mmaakkyyii/makyi_mouse_v2/README.md

# マッキーマウスv2
これはマッキーマウスの基板用リポジトリです  
ソフトは[こちら](https://github.com/mmaakkyyii/makyi_mouse_FW)

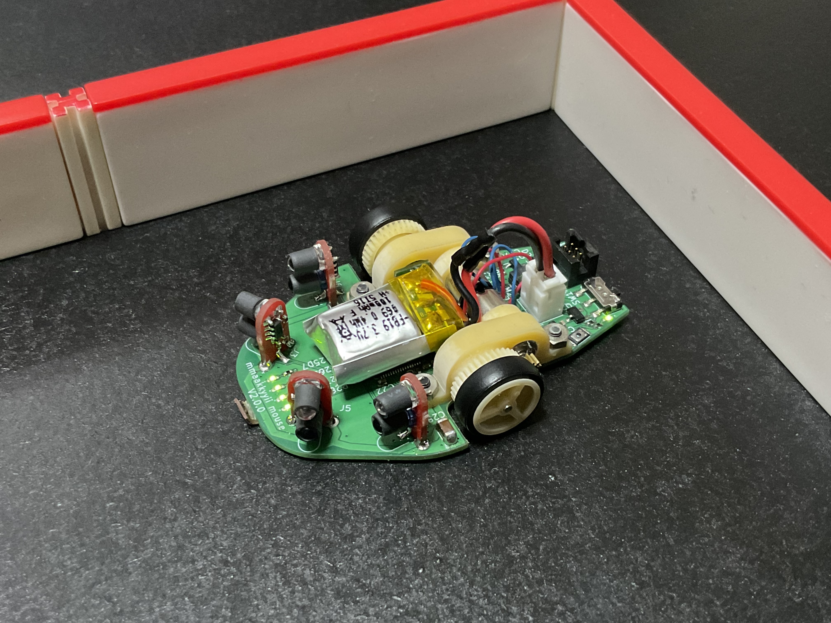
[picture p1: doc/mmaakkyyii_mouse_v2_0_1.jpg]
