mmaakkyyii/makyi_mouse_v2/doc/mmaakkyyii_mouse_v2_0_0.jpg

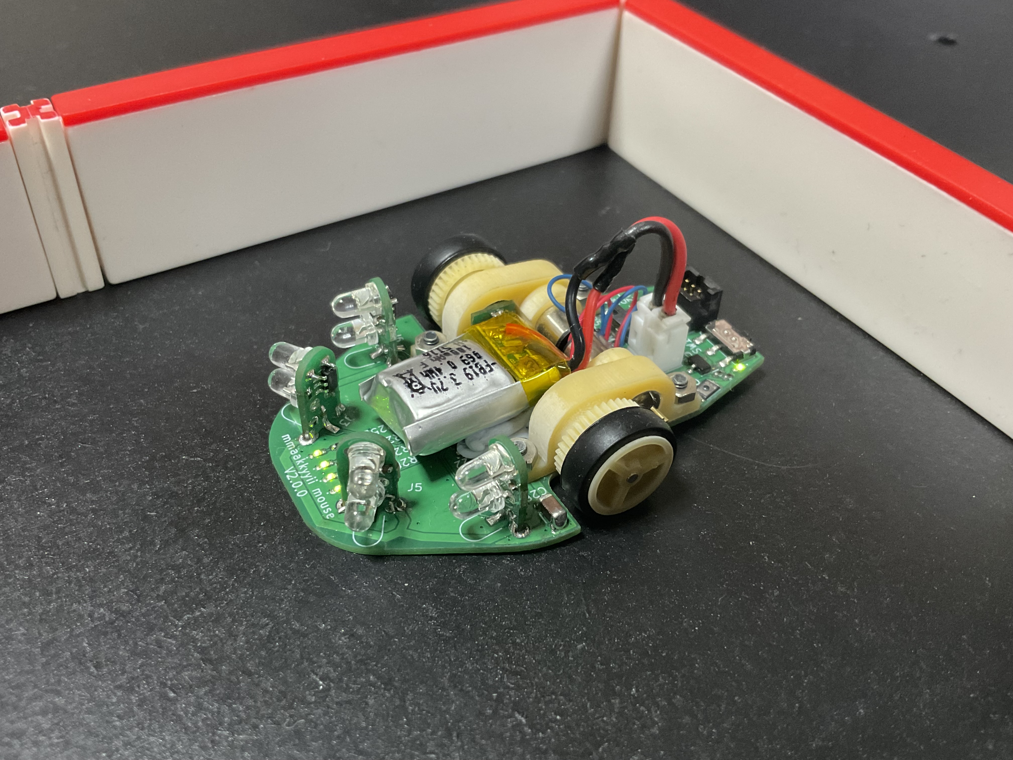
doc/mmaakkyyii_mouse_v2_0_0.jpg
