mmaakkyyii/makyi_mouse_v2/wall_sensor.step

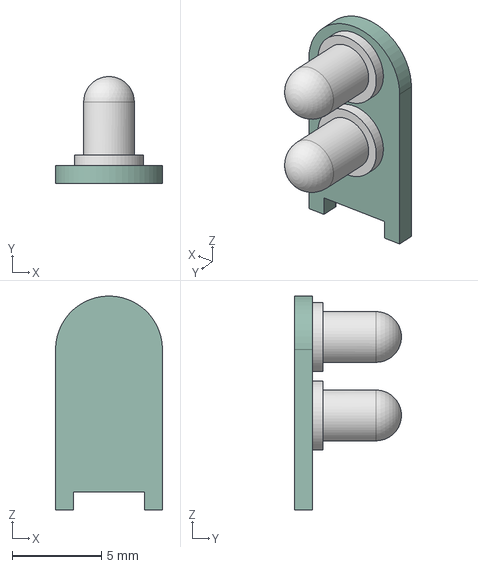
[picture p3: CAD file, 2024-06-23]
wall_sensor.step
6.00 x 6.00 x 12.0 mm
