mmaakkyyii/makyi_mouse_v2/mount_model_R.step

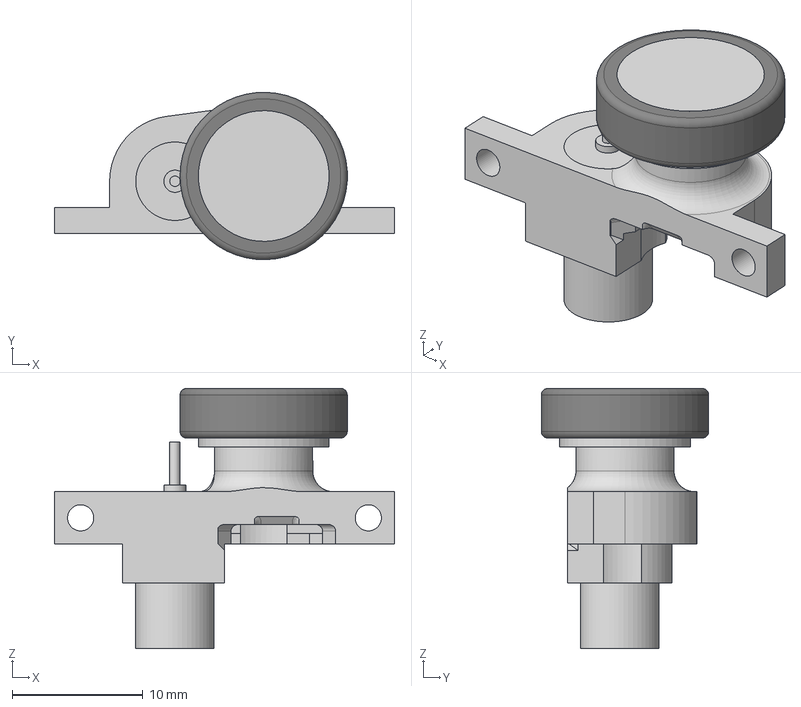
[picture p4: CAD file, 2024-06-23]
mount_model_R.step
26.0 x 12.8 x 19.9 mm
mount
NFP-D0612
tiya
