mmaakkyyii/makyi_mouse_v2/DRV8836.stp

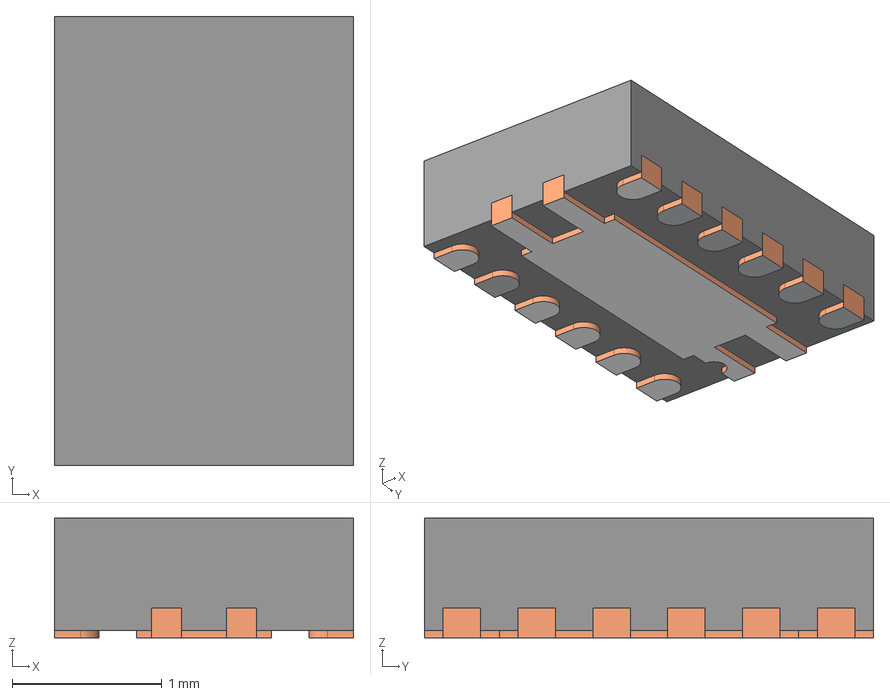
[picture p5: CAD file, 2024-06-23]
DRV8836.stp
2.00 x 3.00 x 0.8 mm
BODY-SON
FRAME-DSS0012A
PIN1-ID
