mmaakkyyii/makyi_mouse_v2/20021221-00006XXLFc.stp

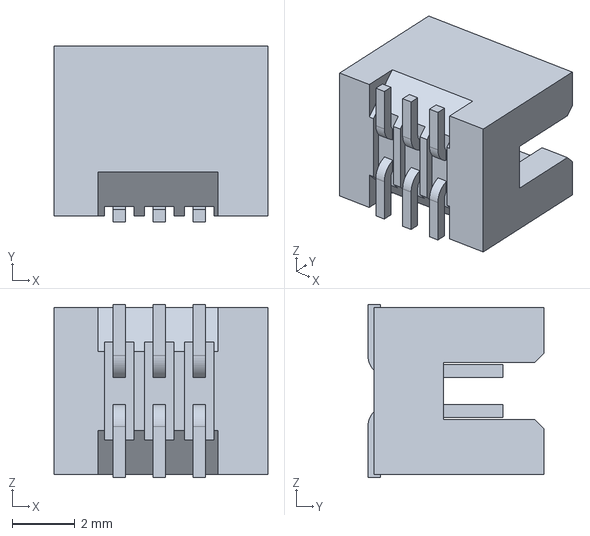
[picture p6: CAD file, 2024-06-23]
20021221-00006XXLFc.stp
6.80 x 5.60 x 5.50 mm
