mmaakkyyii/makyi_mouse_v2/(list of files, cad)

Other CAD files:
mount_model_L.step
