mmaakkyyii/makyi_mouse_v2/makyi_mouse.kicad_pcb

## KiCad design makyi_mouse.kicad_pcb (2024-06-29)

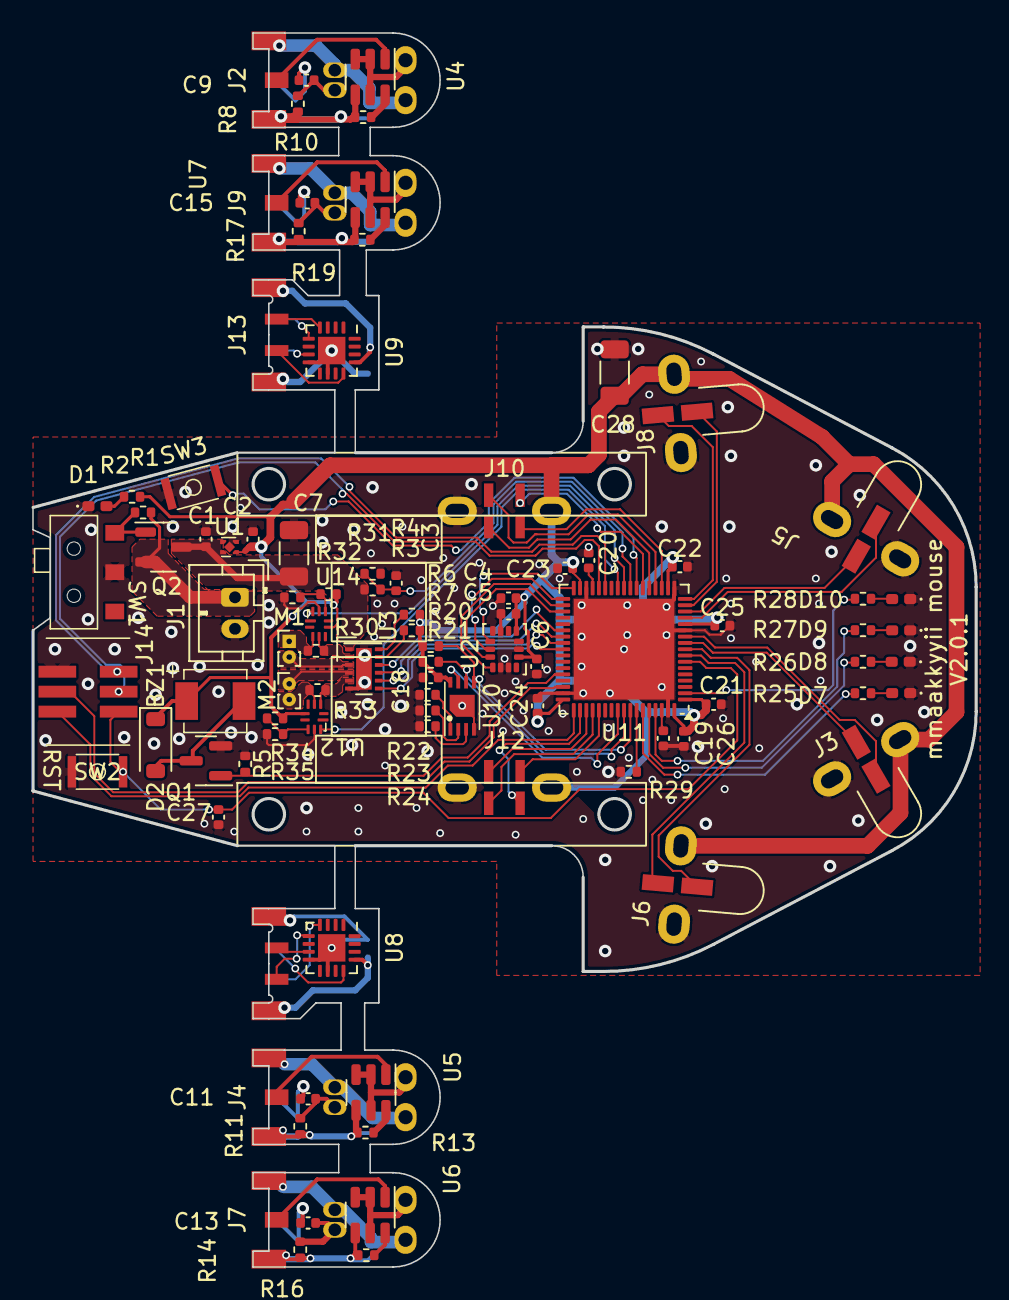
[picture p7: board makyi_mouse.kicad_pcb from above]

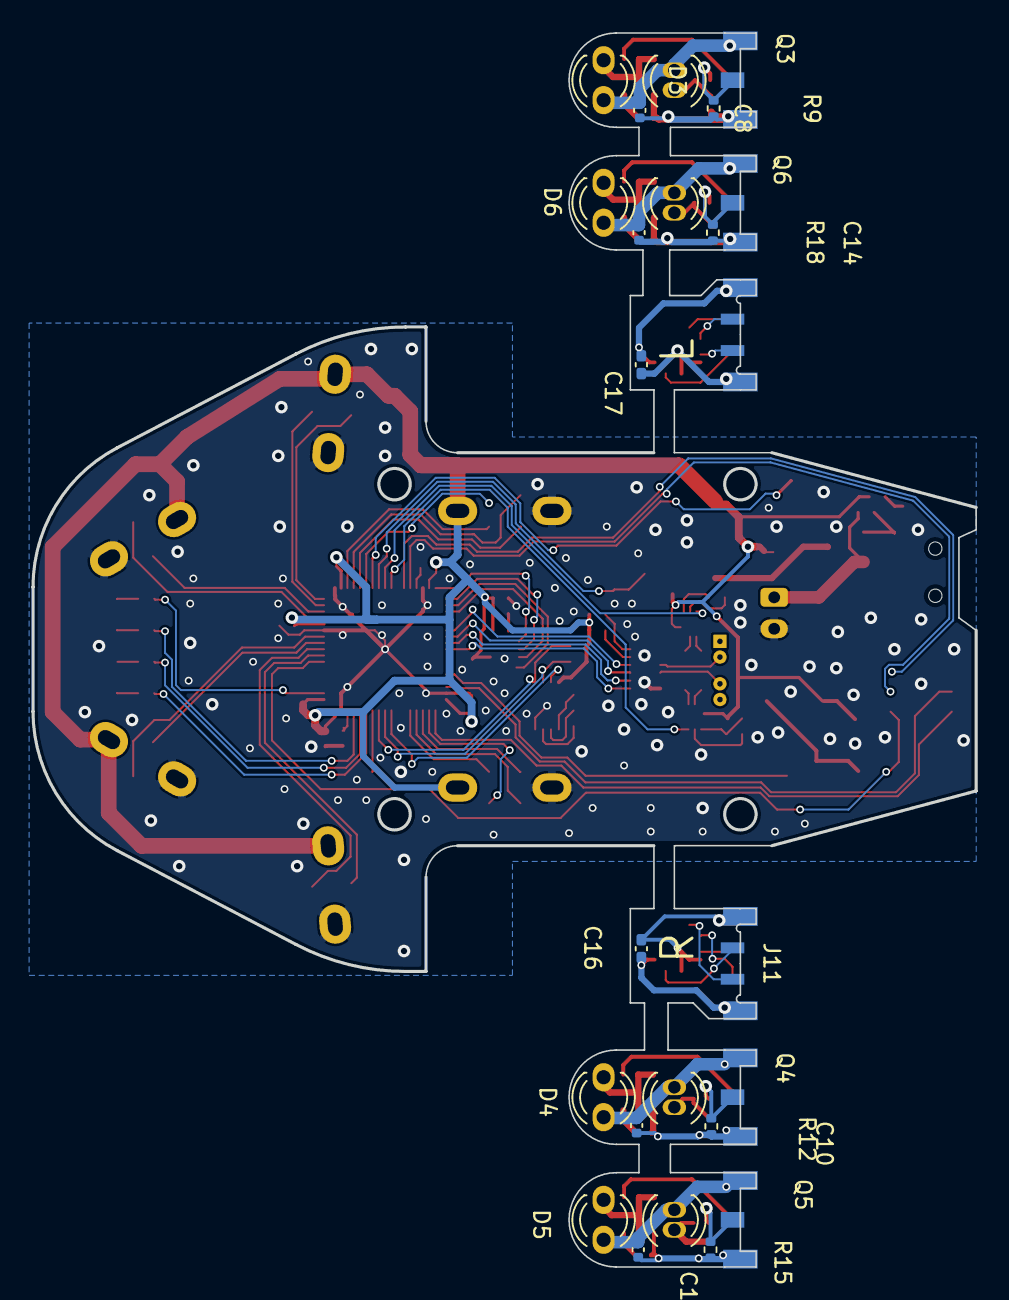
[picture p8: board makyi_mouse.kicad_pcb from below]

Board: 2 copper layers, 60.0 x 78.5 mm, 112 parts (19 on the bottom side), 108 nets.

Parts:
BZ1: SMT-0440-T-HT-R
C1, C2, C8, C10, C12, C14: 1u; C_0402_1005Metric
C3, C5, C9, C11, C13, C15, C18, C21, C22, C23, C24, C25, C26, C27: 0.1u; C_0402_1005Metric
C4, C19, C20: 2.2u; C_0402_1005Metric
C6: 0.01u; C_0402_1005Metric
C7, C28: 10u; C_1206_3216Metric
C16, C17: 0.1u; C_0402_1005Metric_Pad0.74x0.62mm_HandSolder
D1, D7, D8, D9, D10: LED; LED_0402_1005Metric_Pad0.77x0.64mm_HandSolder
D2: C258207; D_SOD-123
D3, D4, D5, D6: OSI5FU3A11C; LED
J1: Conn_01x02_Pin; JST_PH_B2B-PH-K_1x02_P2.00mm_Vertical
J2, J4, J7, J9: Conn_01x04_Pin; wall_sensor_board
J3, J5, J6, J8: Conn_01x04_Pin; wall_sensor_fp
J10, J12: Conn_01x06_Pin; enc_fp
J11, J13: Conn_01x06_Pin; enc_board
J14: 20021221-00006C4LF
M1, M2: Motor_DC; PinHeader_1x02_P1.00mm_Vertical
Q1: DMN63D8L-7; SOT-23
Q2: GSFC02A05; SOT-23-3
Q3, Q4, Q5, Q6: OP505A; LED_photo_tr
R1: 100k; R_0402_1005Metric
R2, R20, R21, R25, R26, R27, R28: 3.3k; R_0402_1005Metric
R3: 6.8k; R_0402_1005Metric
R4: 15k; R_0402_1005Metric
R5, R9, R12, R15, R18, R30, R31, R32, R33, R34, R35: 10k; R_0402_1005Metric
R6, R7, R22, R23, R24, R29: 0; R_0402_1005Metric
R8, R11, R14, R17: 1.5k; R_0402_1005Metric
R10, R13, R16, R19: 8.2; R_0402_1005Metric
SW1: AYZ0102AGRLC
SW2, SW3: C5143614
U1: NCP177AMX330TCG; XDFN4
U2: ICM-42688-P; LGA-14_3x2.5mm_P0.5mm_LayoutBorder3x4y
U3: DRV8836DSSR; WSON-12-1EP_3x2mm_P0.5mm_EP1x2.65
U4, U5, U6, U7: BCR421UW6-7; SOT-23-6
U8, U9: MA730; QFN-16-1EP_3x3mm_P0.5mm_EP1.75x1.75mm
U10: v; LCC-8P-M04
U11: STM32H573RIVx; QFN-68-1EP_8x8mm_P0.4mm_EP6.4x6.4mm
U12, U14: INA210; UQFN-10

Connections:
+3.3V: BZ1.1 (-), C2.1, C4.1, C5.1, C6.1, C18.1, C21.1, C22.1, C23.1, C24.1, C25.1, C26.1, C28.1, D2.1 (K), J3.4, J5.4, J6.4, J8.4, J10.1, J12.1, R2.1, R6.2, R7.2, R20.1, R21.1, R31.1, R34.1, U1.1 (OUT), U2.5 (VDDIO), U2.8 (VDD), U10.8 (VDD), U11.1 (VBAT), U11.13 (VDDA), U11.19 (VDD), U11.33 (VDD), U11.51 (VDD), U11.68 (VDD), U12.6 (V+), U14.6 (V+)
/AIN1: U3.10 (AIN1/APHASE), U11.40 (PC6)
/AIN2: U3.9 (AIN2/AENBL), U11.41 (PC7)
/BATT_ADC: C3.1, R3.2, R4.1, U11.25 (PC5)
/BIN1: U3.8 (BIN1/BPHASE), U11.42 (PC8)
/BIN2: U3.7 (BIN2/BENBL), U11.43 (PC9)
/BUZZER: Q1.1 (G), R5.2, U11.47 (PA11)
/DEBUG_RX: J14.3, U11.30 (PB11)
/DEBUG_TX: J14.5, U11.29 (PB10)
/ENC_L_CS: J10.4, U11.20 (PA4)
/ENC_L_MISO: J10.5, U11.22 (PA6)
/ENC_L_MOSI: J10.2, U11.23 (PA7)
/ENC_L_SCLK: J10.3, U11.21 (PA5)
/ENC_R_CS: J12.4, U11.53 (PA15(JTDI))
/ENC_R_MISO: J12.5, U11.55 (PC11)
/ENC_R_MOSI: J12.2, U11.56 (PC12)
/ENC_R_SCLK: J12.3, U11.54 (PC10)
/Flash_SCL: R21.2, U10.6 (SCL), U11.60 (PB6)
/Flash_SDA: R20.2, U10.5 (SDA), U11.61 (PB7)
/Flash_WP: U10.7 (WP), U11.59 (PB5)
/IMU_CS: U2.12 (AP_CS), U11.34 (PB12)
/IMU_MISO: U2.1 (AP_SDO/AP_AD0), U11.36 (PB14)
/IMU_MOSI: U2.14 (AP_SDA/AP_SDIO/AP_SDI), U11.37 (PB15)
/IMU_SCLK: U2.13 (AP_SCLK/AP_SCLK), U11.35 (PB13)
/I_left: U11.26 (PB0), U14.10
/I_right: U11.27 (PB1), U12.10
/LED1: R25.1, U11.63 (PB8)
/LED2: R26.1, U11.64 (PB9)
/LED3: R27.1, U11.65 (PE0)
/LED4: R28.1, U11.2 (PC13)
/LED_FL: J8.1, U11.17 (PA3)
/LED_FR: J6.1, U11.8 (PC0)
/LED_L: J5.1, U11.15 (PA1)
/LED_R: J3.1, U11.10 (PC2)
/NRST: C27.1, J14.1, SW2.2, U11.7 (NRST)
/SENSOR_FL: J8.2, U11.16 (PA2)
/SENSOR_FR: J6.2, U11.9 (PC1)
/SENSOR_L: J5.2, U11.14 (PA0)
/SENSOR_R: J3.2, U11.11 (PC3)
/SWCLK: J14.2, U11.52 (PA14(JTCK)
/SWDIO: J14.4, U11.49 (PA13(JTMS)
/USER_SW: SW3.2, U11.24 (PC4)
/encorder1/CS: J13.4, U9.5 (~CS)
/encorder1/MISO: J13.5, U9.7 (MISO)
/encorder1/MOSI: J13.2, U9.4 (MOSI)
/encorder1/SCLK: J13.3, U9.12 (SCLK)
/encorder/CS: J11.4, U8.5 (~CS)
/encorder/MISO: J11.5, U8.7 (MISO)
/encorder/MOSI: J11.2, U8.4 (MOSI)
/encorder/SCLK: J11.3, U8.12 (SCLK)
/wall_sensor1/ENC_3.3V: C10.1, D4.2 (A), J4.4, Q4.1 (C)
/wall_sensor1/ENC_GND: C10.2, J4.3, R11.2, R12.2, R13.1, U5.4 (GND)
/wall_sensor1/ENC_LED: J4.1, U5.1 (EN)
/wall_sensor1/ENC_OUT: C11.1, J4.2, R12.1
/wall_sensor2/ENC_3.3V: C12.1, D5.2 (A), J7.4, Q5.1 (C)
/wall_sensor2/ENC_GND: C12.2, J7.3, R14.2, R15.2, R16.1, U6.4 (GND)
/wall_sensor2/ENC_LED: J7.1, U6.1 (EN)
/wall_sensor2/ENC_OUT: C13.1, J7.2, R15.1
/wall_sensor3/ENC_3.3V: C14.1, D6.2 (A), J9.4, Q6.1 (C)
/wall_sensor3/ENC_GND: C14.2, J9.3, R17.2, R18.2, R19.1, U7.4 (GND)
/wall_sensor3/ENC_LED: J9.1, U7.1 (EN)
/wall_sensor3/ENC_OUT: C15.1, J9.2, R18.1
/wall_sensor/ENC_3.3V: C8.1, D3.2 (A), J2.4, Q3.1 (C)
/wall_sensor/ENC_GND: C8.2, J2.3, R8.2, R9.2, R10.1, U4.4 (GND)
/wall_sensor/ENC_LED: J2.1, U4.1 (EN)
/wall_sensor/ENC_OUT: C9.1, J2.2, R9.1
GND: C1.2, C2.2, C3.2, C4.2, C5.2, C6.2, C7.2, C18.2, C19.2, C20.2, C21.2, C22.2, C23.2, C24.2, C25.2, C26.2, C27.2, C28.2, D1.1 (K), D7.1 (K), D8.1 (K), D9.1 (K), D10.1 (K), J1.2, J3.3, J5.3, J6.3, J8.3, J10.6, J12.6, J14.6, Q1.2 (S), R4.2, R5.1, R22.2, R23.2, R24.2, R29.2, R32.1, R35.1, SW1.2 (B), SW2.1, SW3.1, U1.2 (GND), U2.2 (RESV), U2.3 (RESV), U2.6 (GND), U2.7 (RESV), U2.10 (RESV), U2.11 (RESV), U3.6 (GND), U3.13 (EPAD), U10.4 (VSS), U10.9 (VSS), U11.12 (VSSA), U11.18 (VSS), U11.32 (VSS), U11.50 (VSS), U11.67 (VSS), U11.69 (VSS), U12.9 (GND), U14.9 (GND)
unnamed: BZ1.2 (+), D2.2 (A), Q1.3 (D)
unnamed: C19.1, U11.66 (VCAP)
unnamed: C20.1, U11.31 (VCAP)
unnamed: D1.2 (A), R2.2
unnamed: D3.1 (K), U4.2 (OUT), U4.3 (OUT), U4.5 (OUT)
unnamed: D4.1 (K), U5.2 (OUT), U5.3 (OUT), U5.5 (OUT)
unnamed: D5.1 (K), U6.2 (OUT), U6.3 (OUT), U6.5 (OUT)
unnamed: D6.1 (K), U7.2 (OUT), U7.3 (OUT), U7.5 (OUT)
unnamed: D7.2 (A), R25.2
unnamed: D8.2 (A), R26.2
unnamed: D9.2 (A), R27.2
unnamed: D10.2 (A), R28.2
unnamed: J1.1, Q2.2 (S), R1.1
unnamed: C16.1, J11.1, U8.13 (VDD)
unnamed: C16.2, J11.6, U8.8 (GND), U8.10 (TEST), U8.17 (PAD)
unnamed: C17.1, J13.1, U9.13 (VDD)
unnamed: C17.2, J13.6, U9.8 (GND), U9.10 (TEST), U9.17 (PAD)
unnamed: M1.1 (+), R30.1, U14.3 (+)
unnamed: M1.2 (-), U3.3 (AOUT2)
unnamed: M2.1 (+), U3.4 (BOUT1)
unnamed: M2.2 (-), R33.2, U12.4 (-)
unnamed: Q2.1 (G), R1.2, SW1.1 (A)
unnamed: C9.2, Q3.2 (E), R8.1
unnamed: C11.2, Q4.2 (E), R11.1
unnamed: C13.2, Q5.2 (E), R14.1
unnamed: C15.2, Q6.2 (E), R17.1
unnamed: R7.1, U3.11 (MODE)
unnamed: R6.1, U3.12 (nSLEEP)
unnamed: R10.2, U4.6 (R_EXT)
unnamed: R13.2, U5.6 (R_EXT)
unnamed: R16.2, U6.6 (R_EXT)
unnamed: R19.2, U7.6 (R_EXT)
unnamed: R22.1, U10.1 (A0)
unnamed: R23.1, U10.2 (A1)
unnamed: R24.1, U10.3 (A2)
unnamed: R29.1, U11.62 (BOOT0)
unnamed: R33.1, U3.5 (BOUT2), U12.3 (+)
unnamed: R34.2, R35.2, U12.8 (REF)
unnamed: R30.2, U3.2 (AOUT1), U14.4 (-)
unnamed: R31.2, R32.2, U14.8 (REF)
VCC: C1.1, C7.1, Q2.3 (D), R3.1, U1.3 (EN), U1.4 (IN), U3.1 (VCC)
