mmaakkyyii/makyi_mouse_v2/(threads)

Thread 3 (2024-06-29):

壁センサのフォトトランジスタが出っ張ってしまう

mmaakkyyii, 2024-06-29:
この部分のせいでフォトトランジスタが基板から浮いてしまう

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

mmaakkyyii, 2024-06-29:
足の付け根の幅が約1.2 mm(実測値)
で足の付け根の間隔は0.6 mmとかでクリアランス的にはどう頑張っても無理そうなので別の足の形状のものを使う必要がある

mmaakkyyii, 2024-06-29:
代替品として[OP505A](https://www.digikey.jp/ja/products/detail/tt-electronics-optek-technology/OP505A/498692)に採用

https://www.ttelectronics.com/TTElectronics/media/ProductFiles/Datasheet/OP505-506-535-705.pdf
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

mmaakkyyii, 2024-06-29:
v.2.0.1で対応

Closed 2024-07-11.
