mmaakkyyii/makyi_mouse_v2/(commit log)

2024-06-29 写真追加
2024-06-29 画像追加
2024-06-29 壁センサ修正
    [encorder.kicad_sch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]
2024-07-11 画像修正
